trueDKstudent/AL304_wrist_watch/Images/proto_view1.jpg

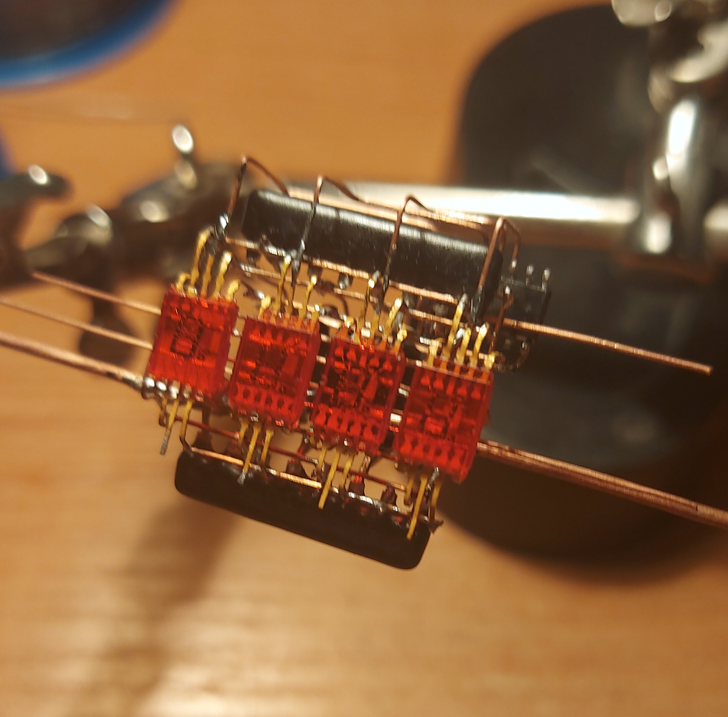
Images/proto_view1.jpg
