trueDKstudent/AL304_wrist_watch/Images/main_pic.jpg

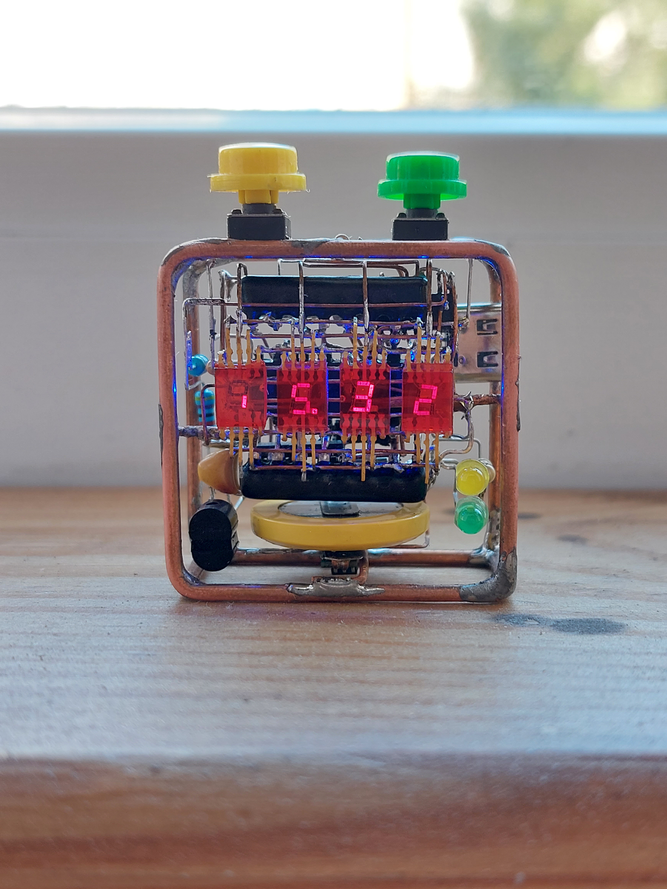
[picture p1: Images/main_pic.jpg]
Images/main_pic.jpg
