trueDKstudent/AL304_wrist_watch/Images/pic3.jpg

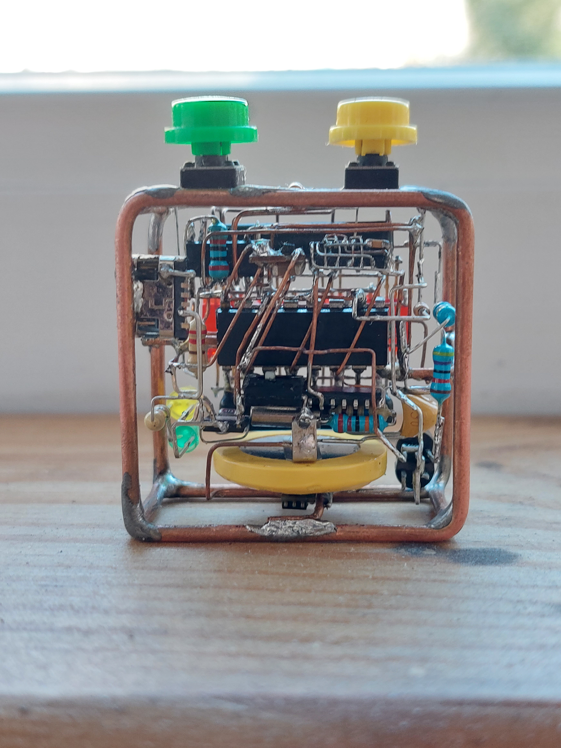
[picture p5: Images/pic3.jpg]
Images/pic3.jpg
